winreboot/esp32s3-lathe/HANDOFF.md

# Hand-off: where the work stands (9 November 2026)

Read `CLAUDE.md` for the working rules, `README.md` for what the system does, `CHANGELOG.md` for every version. This file is the context a new session would otherwise lack: what was decided recently, why, and what is next.

## Current versions
- Firmware **1.9.0** (`platformio.ini`), web page **1.21.1** (`data/index.html`, `FW_MIN` 1.4.0), interface board **rev F** (`hardware/make_pcb.py`).
- 1.9.0: Colours screen (red/blue swap + black background, `dblack`). All screen colours go through `theme()` in main.cpp; never hard-code the background or panel colours again.
- Smooth digits must be drawn with `setTextColor(fg)` only (no background colour): LovyanGFX then uses its read-back alpha-blend path on the sprite. With a background colour it painted dark boxes on the real panel (1.8.2).
- VLW gotcha found in 1.8.2: `VLWfont::getUnicodeIndex` is a binary search, so the glyph table in a .vlw must be sorted by code point; `tools/make_vlw.py` now writes `-` `.` `0`–`9` in that order. Unsorted tables show every character as a placeholder box.
- 1.8.0 drew the smooth digits as empty boxes: LovyanGFX's `VLWfont::drawChar` does `alloca(w*h)` for the glyph bitmap, and the display task had a 6 KB stack. 1.8.1 gives it 24 KB. Keep that in mind if bigger fonts are ever added (the big digit is ~11 KB).
- Display 1.8.0: anti-aliased digits (Oswald Bold, OFL) as VLW fonts in `fonts/`, embedded with `board_build.embed_files`, drawn by `drawNumber()` which picks the largest size that fits. `tools/make_vlw.py <pylib> <ttf> <out dir> <preview.png>` regenerates them (needs Pillow). The user found the scaled bitmap digits pixelated (10 November 2026). Not yet seen on the real panel.
- **Interface change (10 November 2026):** the user bought 4-channel BSS138 level shifter modules and chose them over milling the board. Help, README and the build guide now describe LS1 (spindle A/B/Z taps, HV = 12 V from the encoder supply, shared with the G540 inputs which pull to 12 V), LS2 (X/Z encoders, HV = 12 V), LS3 (charge pump, HV = 5 V because DB25 pin 16 is a 5 V output), plus a 1-channel PC817 module for the isolated spindle control (with the 4.7 kΩ / 10 µF filter still loose). No firmware change was needed: spindle direction is polarity-independent, Z is unused, the charge pump is timed. The milled board stays in the repo and Help as "Milled board (alt.)"; `make_pcb.py` and its rev F files are unchanged.
- Display 1.7.0: View button (Everything / RPM only / X only / Z only / X and Z), saved as `dview`. The user is building the spindle side first and wants RPM only until the axis encoders exist.
- `docs/BUILD_GUIDE.md` (added 9 November 2026) is the illustrated build guide for GitHub; its PNGs in `docs/img/` are screenshots of the dashboard and Help panes (taken with headless Edge from `data/index.html` running on simulated data), renders of the board SVGs, and SVG mock-ups of the four display screens drawn from the firmware's coordinates. Regenerate them when the page or display layout changes.
- Touch confirmed working on the user's panel (10 November 2026). 1.6.0 added a drawn-lathe boot screen, removed the menu header and added an Info screen (firmware, Wi-Fi, address, spindle run hours, powered-on hours). Spindle hours were already counted by the firmware; Info only displays them.
- `data/hw/` holds the rev F files and the filesystem image builds cleanly with all 10 files.
- Display (10 November 2026): the user's DIANN 2.8" ILI9341 module runs with VCC and LED both on 3V3 (its J1 jumper is bridged). 1.4.2 dropped the SPI clock to 20 MHz and added a boot splash; 1.5.0 added the XPT2046 touch panel on the shared bus (T_DO → 13, T_CS → 14) with a tap-anywhere Settings menu (zero X/Z, diameter/radius, flip, red/blue swap, touch calibration, confirmed reboot) and white sub-labels. The user wired the touch pins and reported that calibration and the menu work.

## The interface board, and how it got to rev F
The user mills the board at home on a desktop CNC router from the DXFs the script writes, two-sided, with no plated holes (via pins are bare wire soldered both sides). The sequence of revisions matters because each one answers a problem seen on the real machine:
- **C** two-sided (top traces and via pins replaced wire links; top ground with one isolation ring per lead; alignment holes).
- **D** pull-ups spread out, bottom ground at least 1 mm wide: no slivers between pads.
- **E** 1.0 mm minimum gap between all copper shapes. The user's CAM drew merged "bubble" and "bone" loops wherever shapes were 0.5 mm apart, because the cutter paths on each side of the gap overlapped. The gap, not the drawing, was the cause. Pads shrank to 1.5 mm to make room; bottom ground pieces are joined through GND vias and the top ground.
- **F** (latest) followed an outside CNC review of the rev E files (`PCB_RevE_CNC_Review_and_Recommendations.txt`, in the user's Downloads, not in the repo). Accepted and implemented: one machining operation per layer (ISO_CENTER cutter centre lines for a 0.5 mm cutter, CLEAR_POCKET, COPPER_REF, drills split by size, SLOT as its own 2.0 mm shape, OUTLINE as a plain rectangle); `$INSUNITS` in the DXF header; 6 mm straight-line clearance through the slot to the lathe nets (was 4.9); pads grown to 2.2 mm where room allows (20 of 50; the 30 at 2.54 mm pitch cannot grow without breaking the 1.0 mm gap); alignment holes made asymmetric (y = 3.5 and 74.2 on x = 72) so the board cannot be fitted upside down; CAM SVGs draw the ISO groove at true width.
- Deliberately **not** changed: the CLEAR pockets still touch the copper. Pulling them back to the ISO groove would leave a floating copper strip whenever the user's V-bit cuts narrower than 0.5 mm. The pocket's first pass re-running the ISO groove is intended.
- The script now checks: one ISO path per copper ring on both sides, and that ISO groove plus pockets remove every piece of copper that belongs to no shape.

## Electrical caution carried over from the review
The lathe speed-pot circuit (HIGH, WIPER, LOW at J9) may float at mains potential. The board's answer is the PC817 optocoupler plus the 8 mm surface path and 6 mm air gap; it is not a certified barrier. Help now tells the user to measure HIGH–LOW (must be under 25 V, C1's rating) and each pin against earth before connecting J9. Don't weaken the slot, the gaps or the keep-outs.

## Open items
1. **Not yet verified in the user's CAM program.** Next step for the user: load `board_revF_bottom.dxf`, set up ISO_CENTER as an on-line engrave (cutter ≤ 0.5 mm at depth), CLEAR_POCKET as a pocket, drills, SLOT as a through pocket (≤ 1.5 mm end mill), OUTLINE as an outside profile; confirm the preview shows separate closed loops; then mill both sides. Any merged loops are a cutter-width or offset setting, not the file.
2. **Wi-Fi credentials in `src/main.cpp`**: the `Settings` struct defaults (`ssid`, `pass`, around line 44) contain the user's real network name and password. They should be empty strings (the README says a fresh board opens its own access point). Fix this before the repository is made public; it is a firmware change, so bump `FW_VERSION` and add a CHANGELOG entry.
3. The user's PCB blanks warped when heated; the two-sided design exists partly so no copper has to be stripped. Keep both sides' files from the same revision.

## Tooling notes
- PlatformIO: `$env:USERPROFILE\.platformio\penv\Scripts\pio.exe` (not on PATH). `run -t buildfs` builds the image; `run -t uploadfs` uploads it (erases saved recordings).
- Board script: `python -I hardware/make_pcb.py <folder with shapely and numpy>`. ezdxf is handy for validating the DXFs (R12, closed POLYLINEs; the parts file has intentional open polylines for TO-92 outlines).
- The Help tab in `data/index.html` builds the board download links from `const BOARD_REV`, which the script rewrites.
