winreboot/esp32s3-lathe/dashboard_preview.png

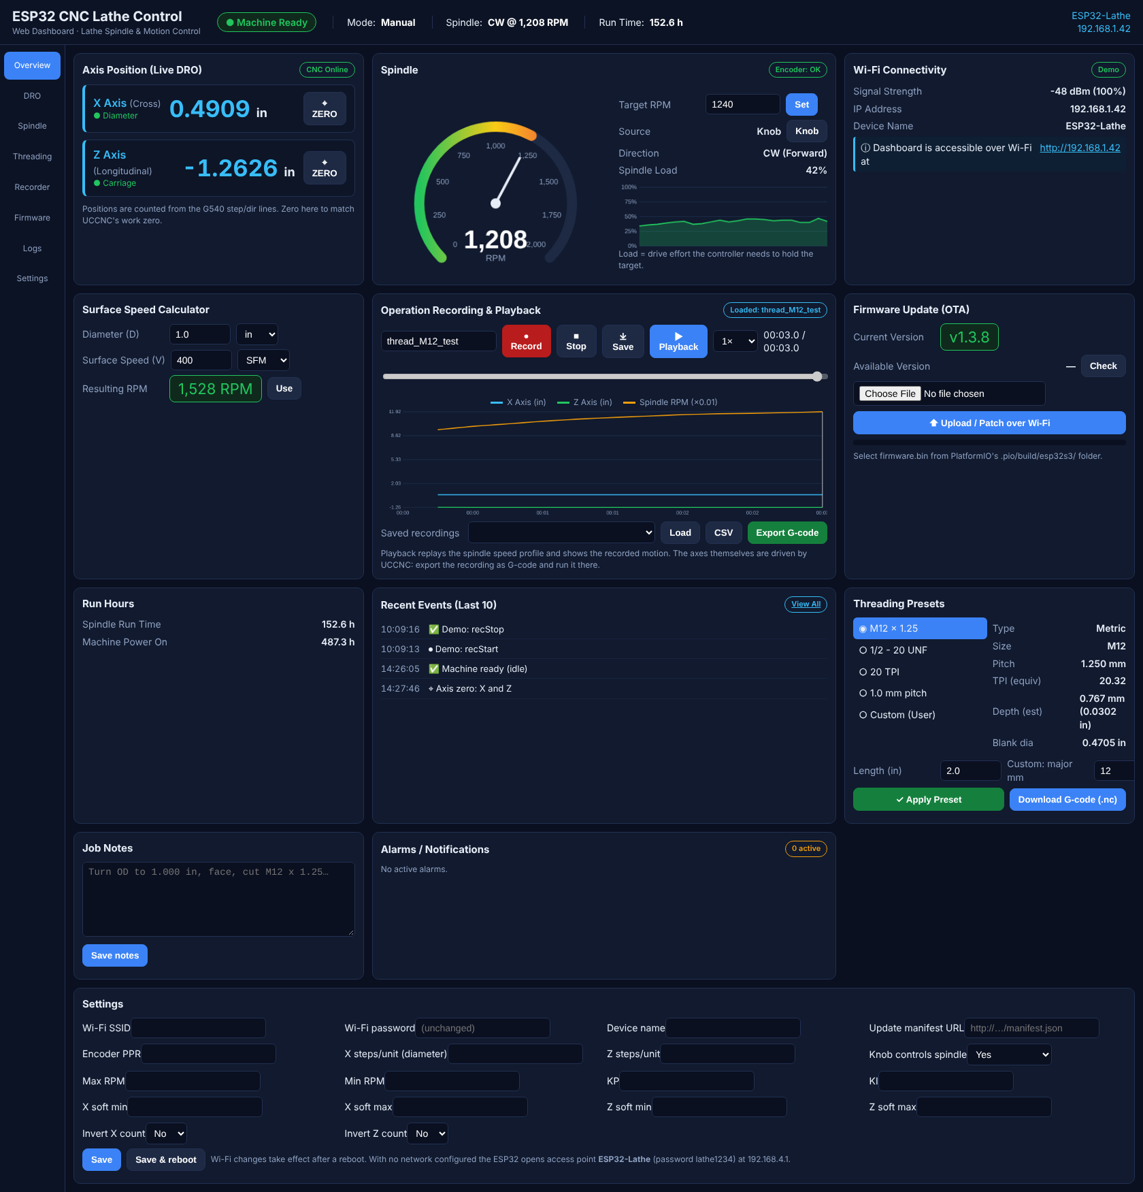
dashboard_preview.png
