winreboot/esp32s3-lathe/docs/img/board_top_cam.png

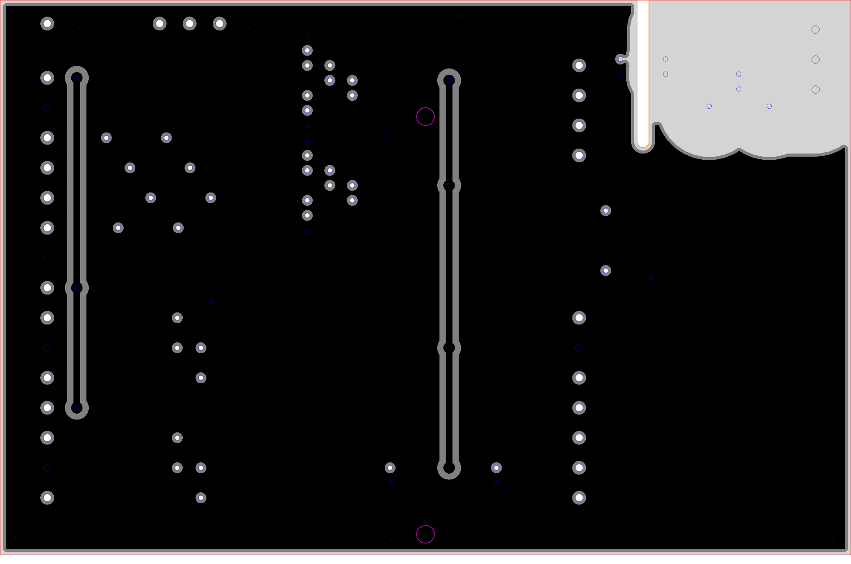
docs/img/board_top_cam.png
