winreboot/esp32s3-lathe/docs/img/help_board.png

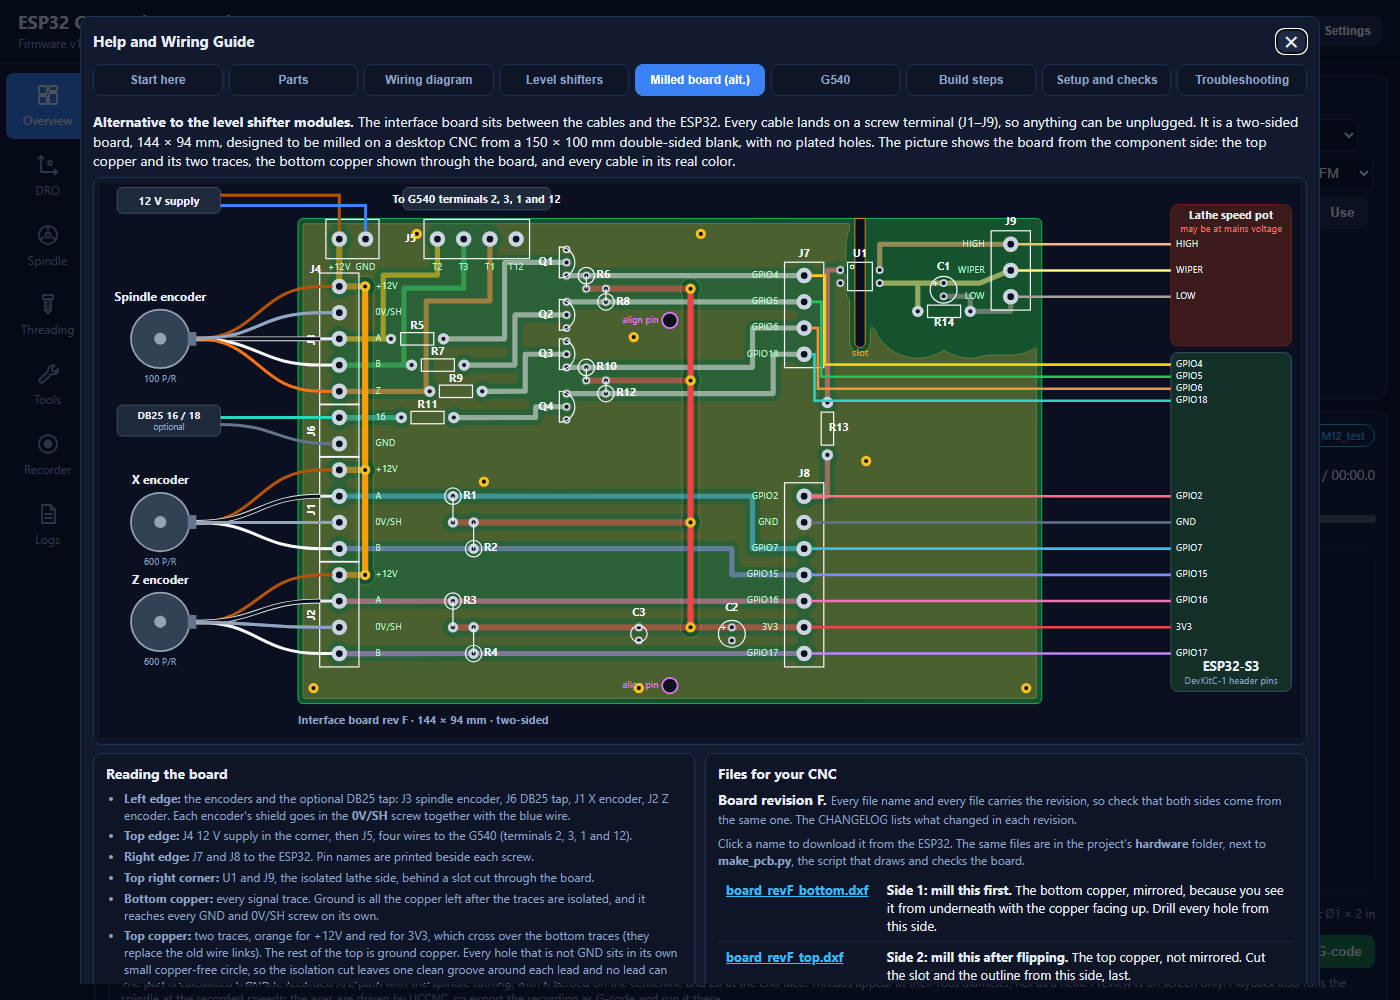
docs/img/help_board.png
