winreboot/esp32s3-lathe/hardware/board_revF_top.dxf

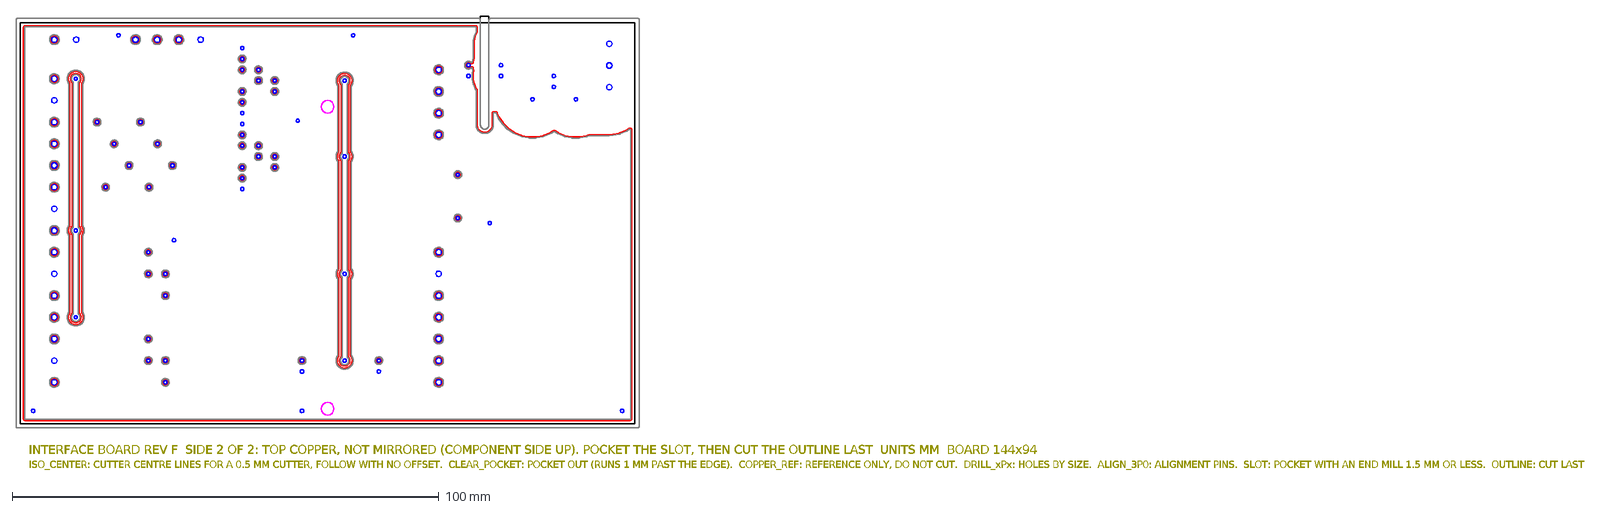
[picture p4: CAD file, 2026-11-09]
hardware/board_revF_top.dxf
INTERFACE BOARD REV F SIDE 2 OF 2: TOP COPPER, NOT MIRRORED (COMPONENT SIDE UP). POCKET THE SLOT, THEN CUT THE OUTLINE LAST UNITS MM BOARD 144x94
ISO_CENTER: CUTTER CENTRE LINES FOR A 0.5 MM CUTTER, FOLLOW WITH NO OFFSET. CLEAR_POCKET: POCKET OUT (RUNS 1 MM PAST THE EDGE). COPPER_REF: REFERENCE ONLY, DO N
