winreboot/esp32s3-lathe/hardware/board_revF_parts.dxf

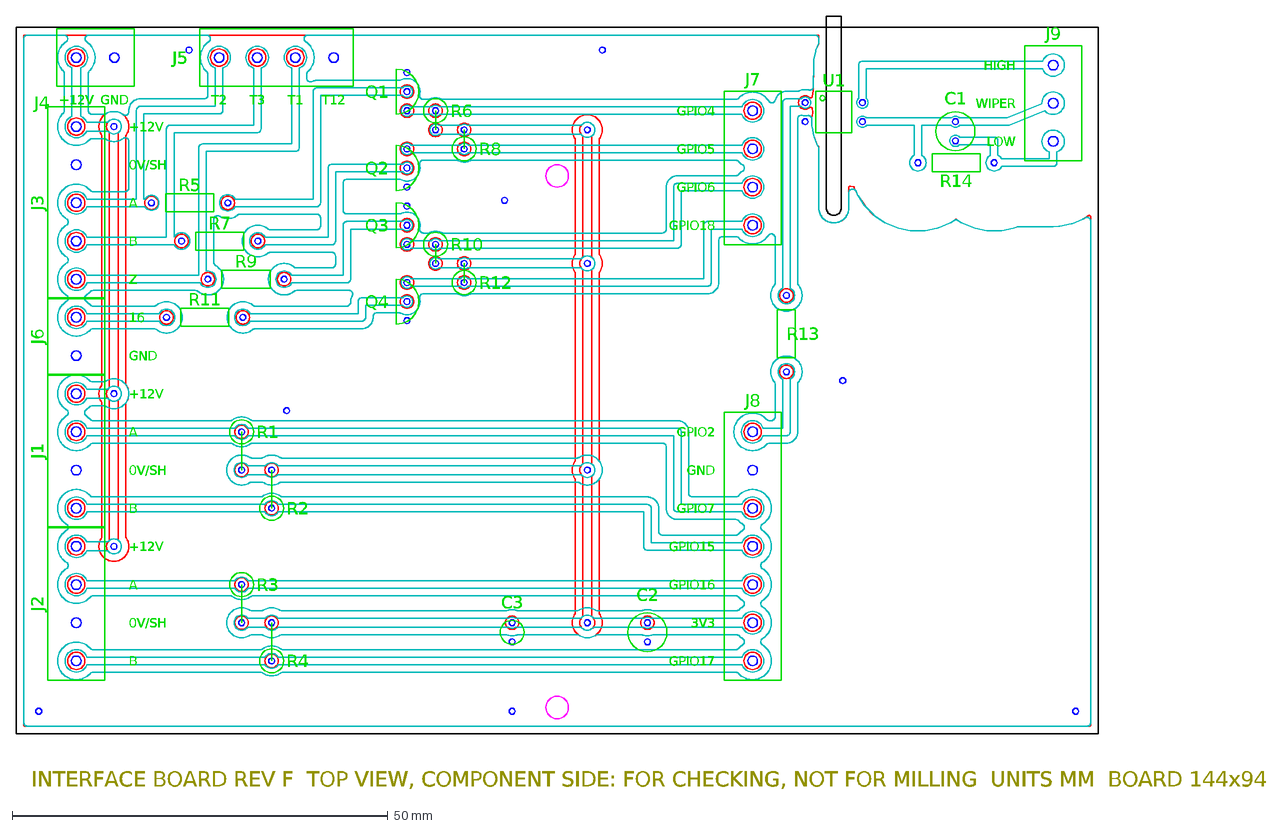
[picture p5: CAD file, 2026-11-09]
hardware/board_revF_parts.dxf
J3
+12V
0V/SH
A
B
Z
J6
16
GND
J1
J2
J4
T2
T3
T1
T12
J5
R5
R7
R9
R11
Q1
Q2
Q3
Q4
R6
R8
R10
R12
J7
GPIO4
GPIO5
GPIO6
GPIO18
J8
GPIO2
GPIO7
GPIO15
GPIO16
3V3
GPIO17
R1
R2
R3
R4
C2
C3
R13
U1
J9
HIGH
WIPER
LOW
R14
C1
INTERFACE BOARD REV F TOP VIEW, COMPONENT SIDE: FOR CHECKING, NOT FOR MILLING UNITS MM BOARD 144x94
