winreboot/esp32s3-lathe/(list of files, cad)

Other CAD files:
hardware/board_revF_bottom.dxf
