winreboot/esp32s3-lathe/docs/img/board_assembly.png

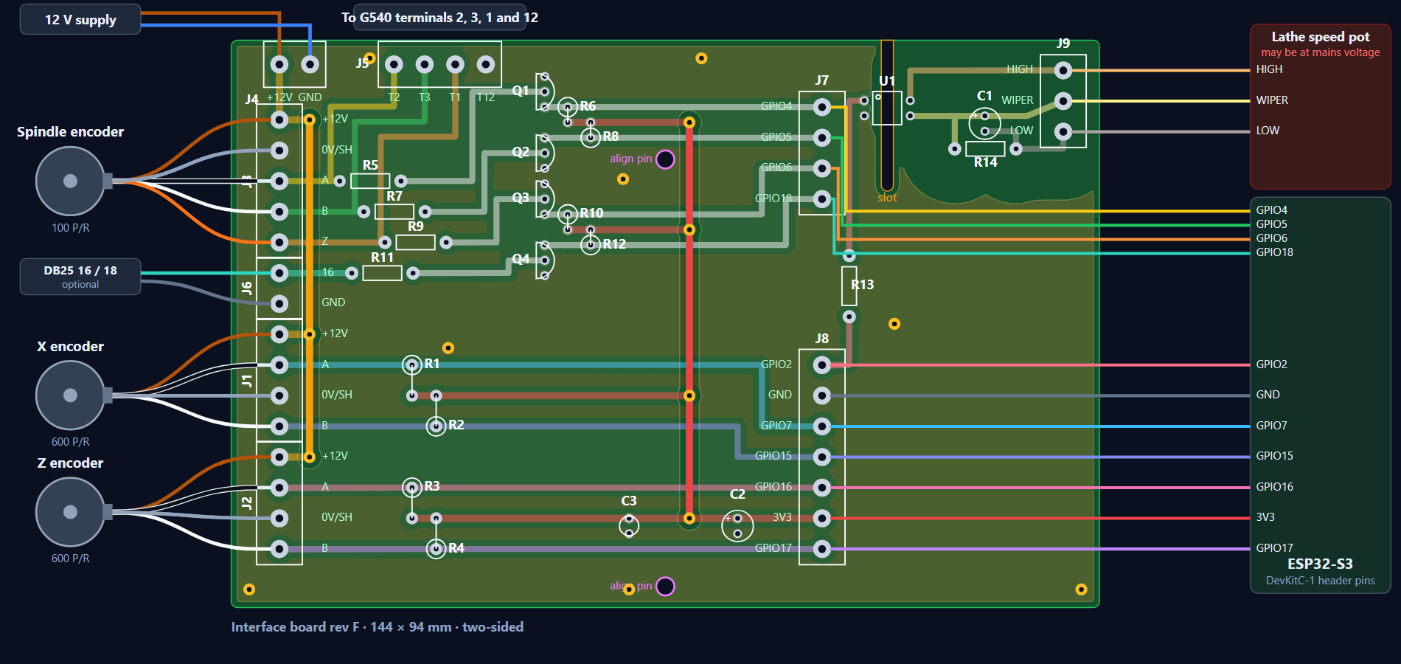
docs/img/board_assembly.png
