winreboot/esp32s3-lathe/(commit log)

2026-11-09 ESP32-S3 lathe control: firmware 1.4.1, page 1.18.0, interface board rev F
    [board_revF_bottom.dxf, board_revF_parts.dxf, board_revF_top.dxf]
2026-11-10 Build guide with pictures (docs/); firmware 1.6.1 menu fix; page 1.20.1 touch wires in diagram
    [main.cpp]
2026-11-10 Level shifter modules replace the board; firmware 1.7.0 View chooser; page 1.21.0; build guide updated
    [main.cpp]
